Liam-Craig/SONATA-ONE-KICAD/README.md

# SONATA-ONE-KICAD
 KiCAD Design files for Sonata PCB, part of the Sunburst Project
 
 Please sumit an issue if you discover problems with this repo. Design converted and refactored from the original altium files.
