Liam-Craig/SONATA-ONE-KICAD/Mechanical.kicad_sch

## KiCad design Mechanical.kicad_sch (2024-08-19)

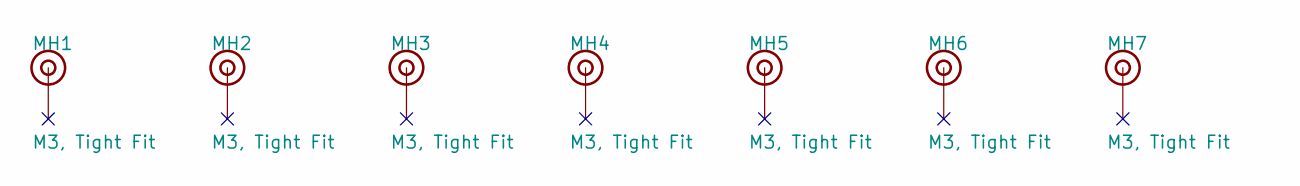
[picture p14: schematic Mechanical.kicad_sch]

Parts:
MH1, MH2, MH3, MH4, MH5, MH6, MH7: M3, Tight Fit; MOUNT_M3_TIGHT
