Liam-Craig/SONATA-ONE-KICAD/(commit log)

2024-08-15 Hierarchical Refactoring
    Restructured the schematic to show connections between sheets
    [Analog_Conversion.kicad_sch, ETHMAC.kicad_sch, FPGA_ANA_1.8V.kicad_sch, FPGA_Config.kicad_sch, FPGA_IO14_34_Flash.kicad_sch, FPGA_IO15_16.kicad_sch, FPGA_PWR.kicad_sch, FTDI_Debug.kicad_sch]
2024-08-15 Cleaned up sheet positioning
    Cleaned up sheet positioning, conversion complete for now.
    [Analog_Conversion.kicad_sch, ETHMAC.kicad_sch, FPGA_ANA_1.8V.kicad_sch, FPGA_Config.kicad_sch, FPGA_IO14_34_Flash.kicad_sch, FPGA_IO15_16.kicad_sch, FPGA_PWR.kicad_sch, FTDI_Debug.kicad_sch]
2024-08-19 Title block improvements
    Improved the info in the title blocks, compacted the root sheet to fit on the same size paper as everything else
    [Analog_Conversion.kicad_sch, ETHMAC.kicad_sch, FPGA_ANA_1.8V.kicad_sch, FPGA_Config.kicad_sch, FPGA_IO14_34_Flash.kicad_sch, FPGA_IO15_16.kicad_sch, FPGA_PWR.kicad_sch, FTDI_Debug.kicad_sch]
